apkbox/metdet/SurfmasterPI/ref/SURF3/Вид8.jpg

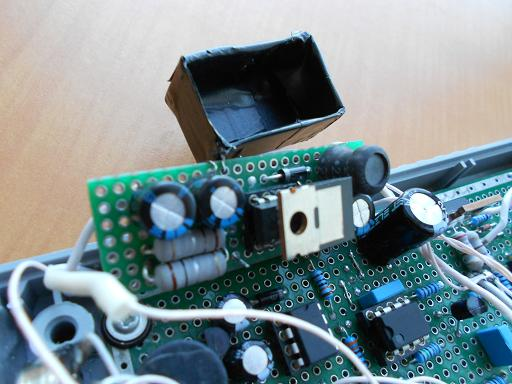
SurfmasterPI/ref/SURF3/Вид8.jpg
