apkbox/metdet/SurfmasterPI/ref/SURF3/Вид7.jpg

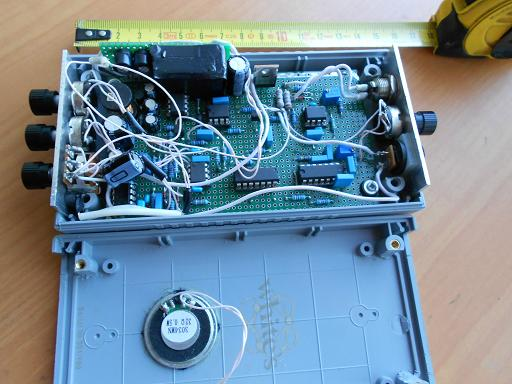
SurfmasterPI/ref/SURF3/Вид7.jpg
