apkbox/metdet/SurfmasterPI/3041_surf_pi_schematic.jpg

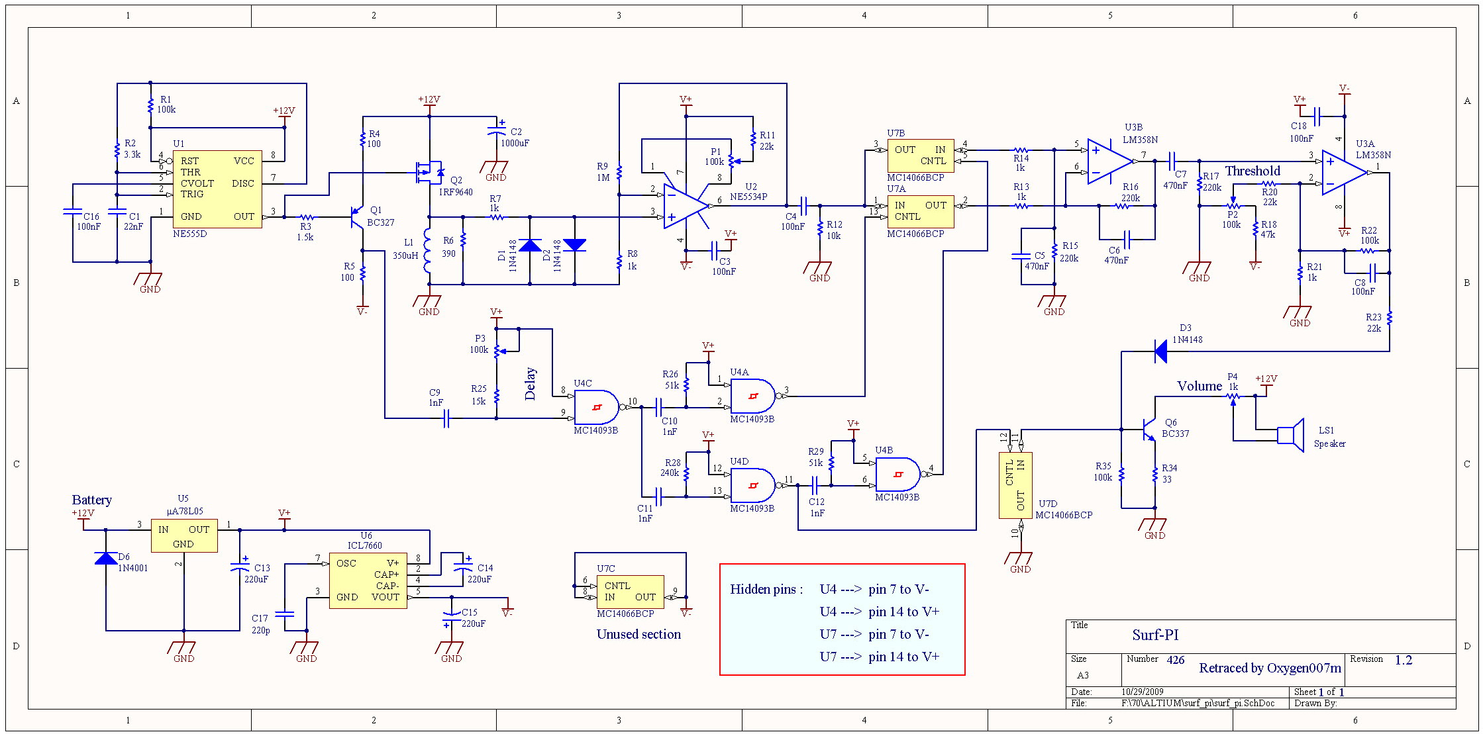
SurfmasterPI/3041_surf_pi_schematic.jpg
