apkbox/metdet/SurfmasterPI/Pro/SurfPiProSch.png

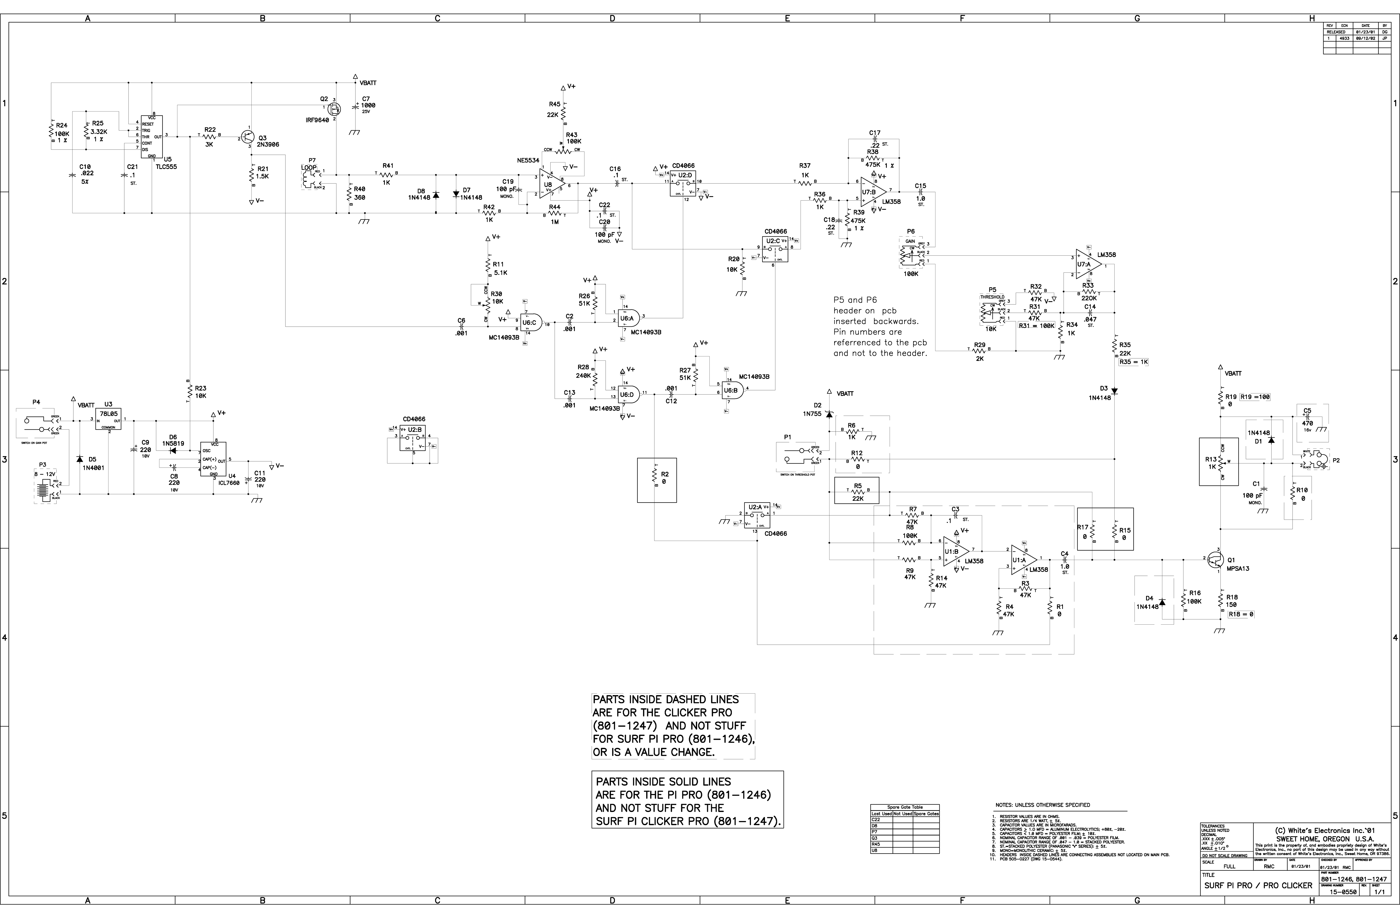
SurfmasterPI/Pro/SurfPiProSch.png
