apkbox/metdet/SurfmasterPI/ref/Cтр,42.jpg

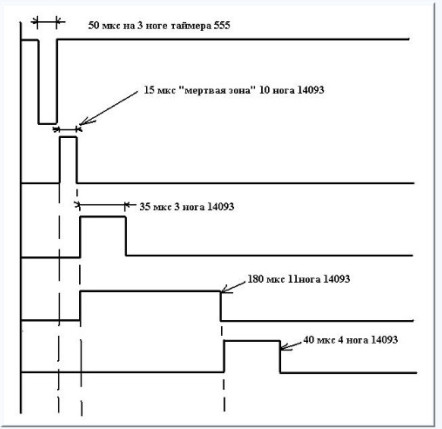
SurfmasterPI/ref/Cтр,42.jpg
