apkbox/metdet/SurfmasterPI/ref/SPProSchematic.png

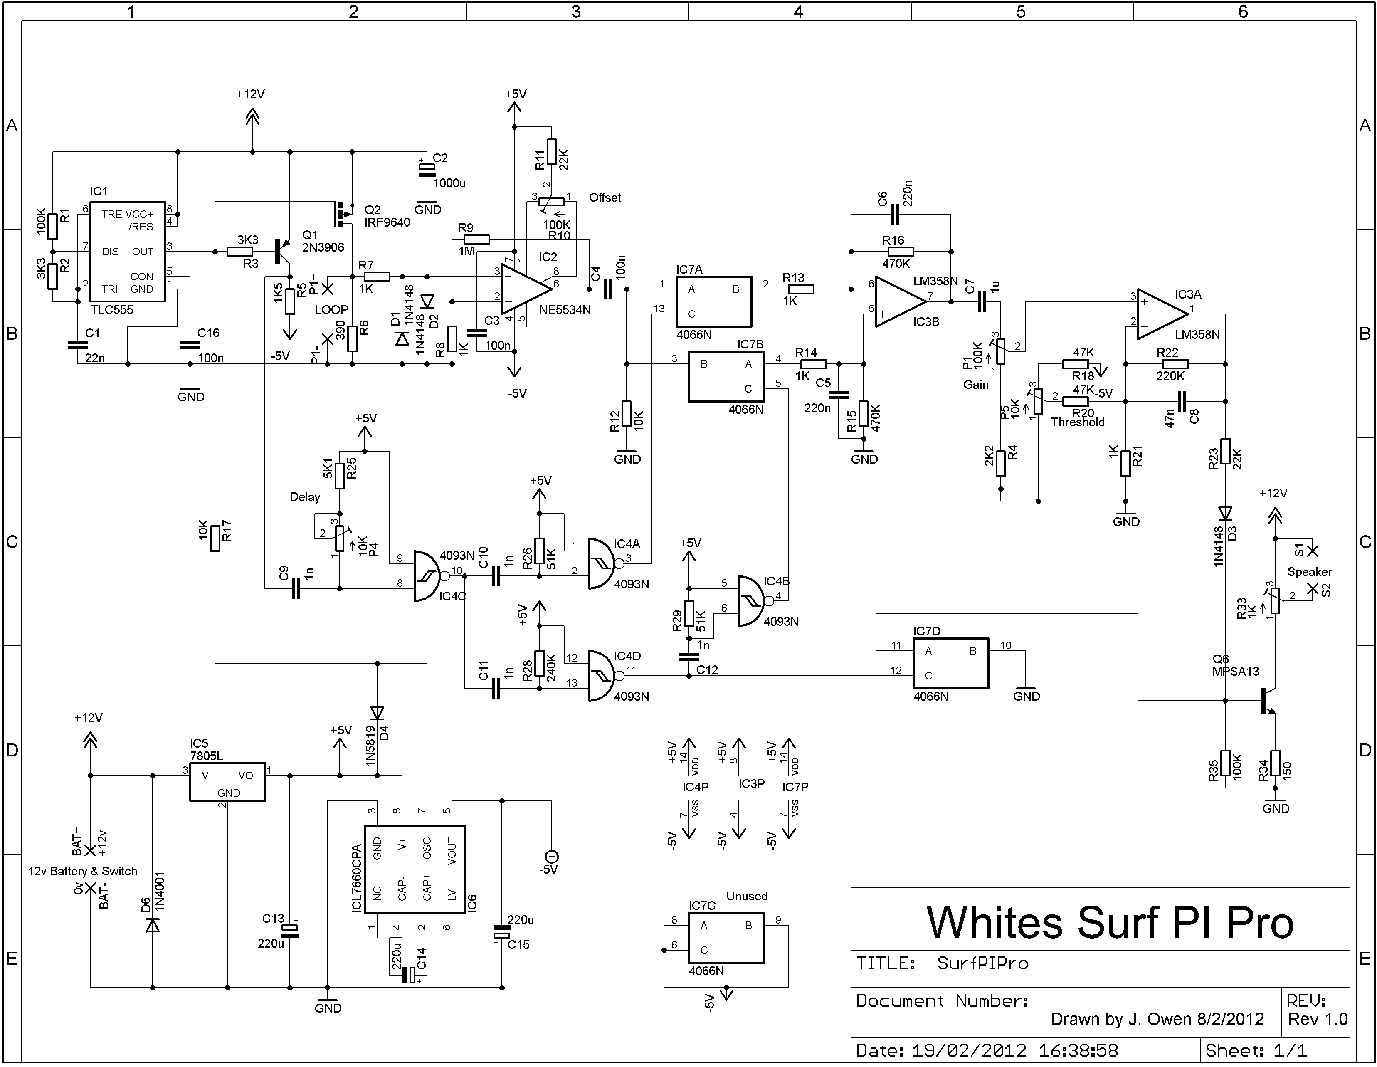
SurfmasterPI/ref/SPProSchematic.png
