apkbox/metdet/SurfmasterPI/ref/SURF1/IMG.jpg

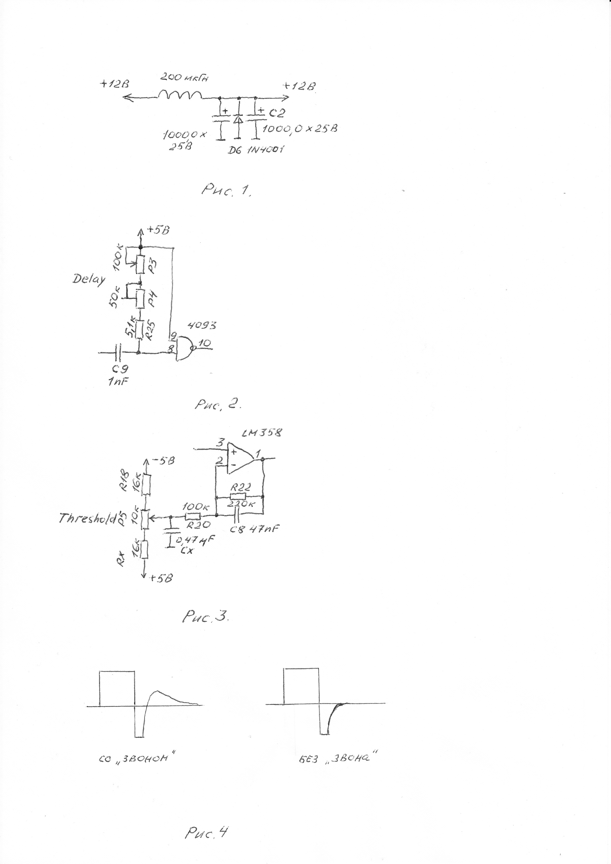
SurfmasterPI/ref/SURF1/IMG.jpg
