apkbox/metdet/SurfmasterPI/ref/SURF2/Вид1.jpg

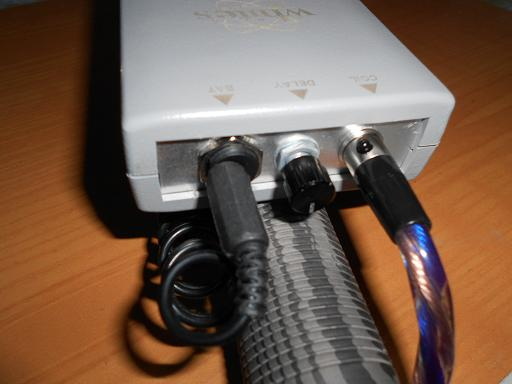
SurfmasterPI/ref/SURF2/Вид1.jpg
