apkbox/metdet/SurfmasterPI/ref/SURF2/Вид2.jpg

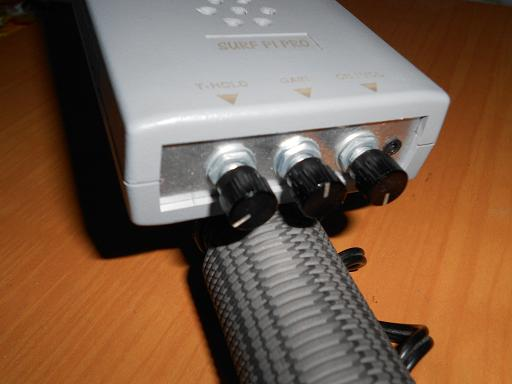
SurfmasterPI/ref/SURF2/Вид2.jpg
