apkbox/metdet/SurfmasterPI/ref/SURF2/Вид3.jpg

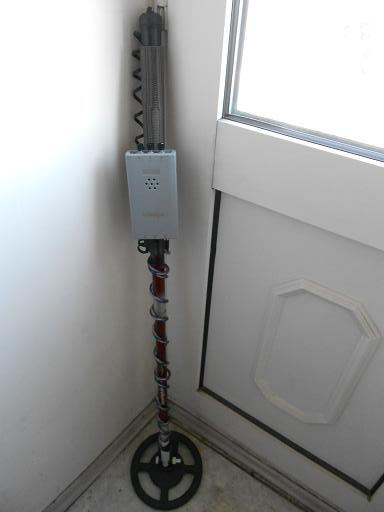
SurfmasterPI/ref/SURF2/Вид3.jpg
