apkbox/metdet/SurfmasterPI/ref/SURF2/Вид4.jpg

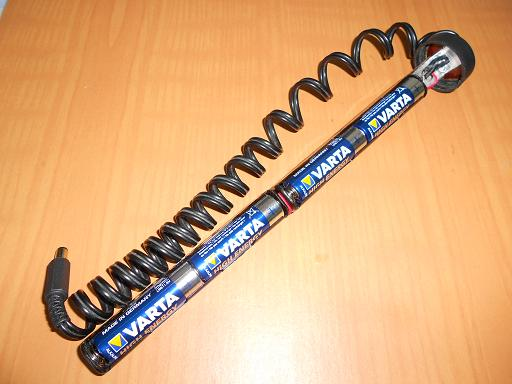
SurfmasterPI/ref/SURF2/Вид4.jpg
