apkbox/metdet/SurfmasterPI/ref/SURF2/Вид5.jpg

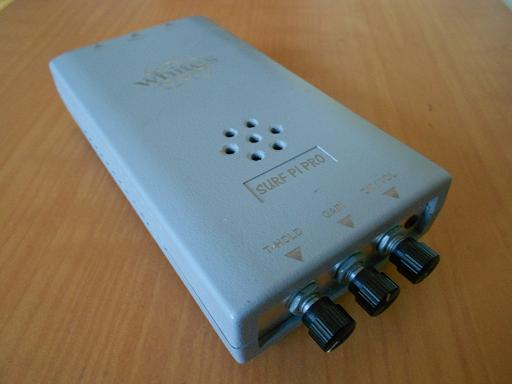
SurfmasterPI/ref/SURF2/Вид5.jpg
