apkbox/metdet/SurfmasterPI/ref/SURF3/Вид6.jpg

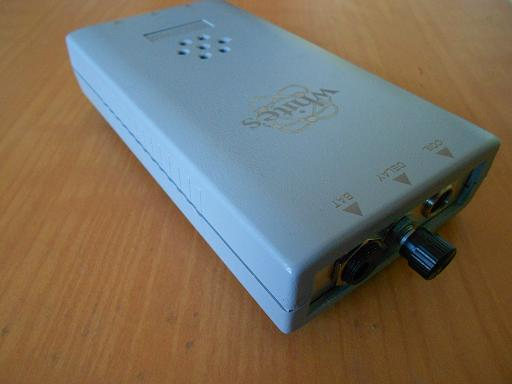
SurfmasterPI/ref/SURF3/Вид6.jpg
