apkbox/metdet/SurfmasterPI/ref/SURF3/Вид9.jpg

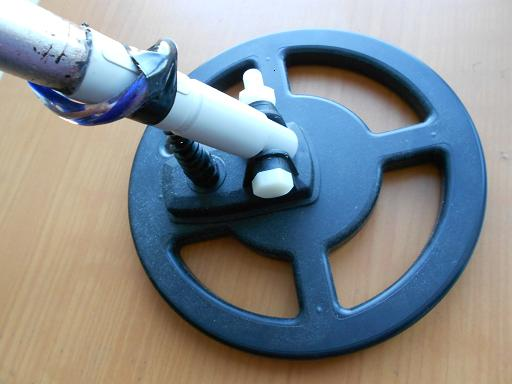
SurfmasterPI/ref/SURF3/Вид9.jpg
