apkbox/metdet/SurfmasterPI/ref/Стр.40.gif

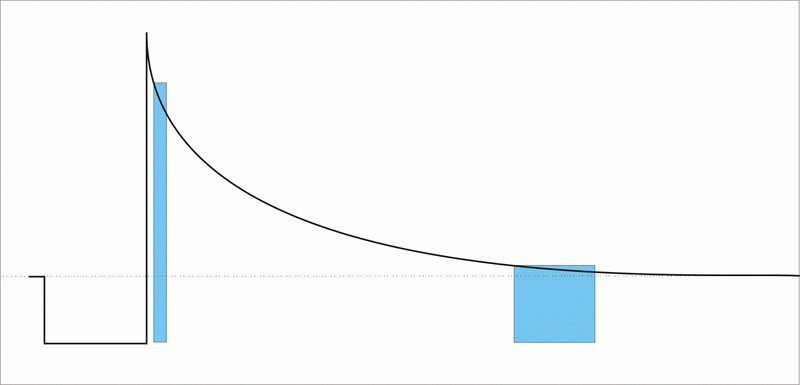
SurfmasterPI/ref/Стр.40.gif
