apkbox/metdet/SurfmasterPI/pcb/SurfmasterPI_pro-B.Cu.pdf

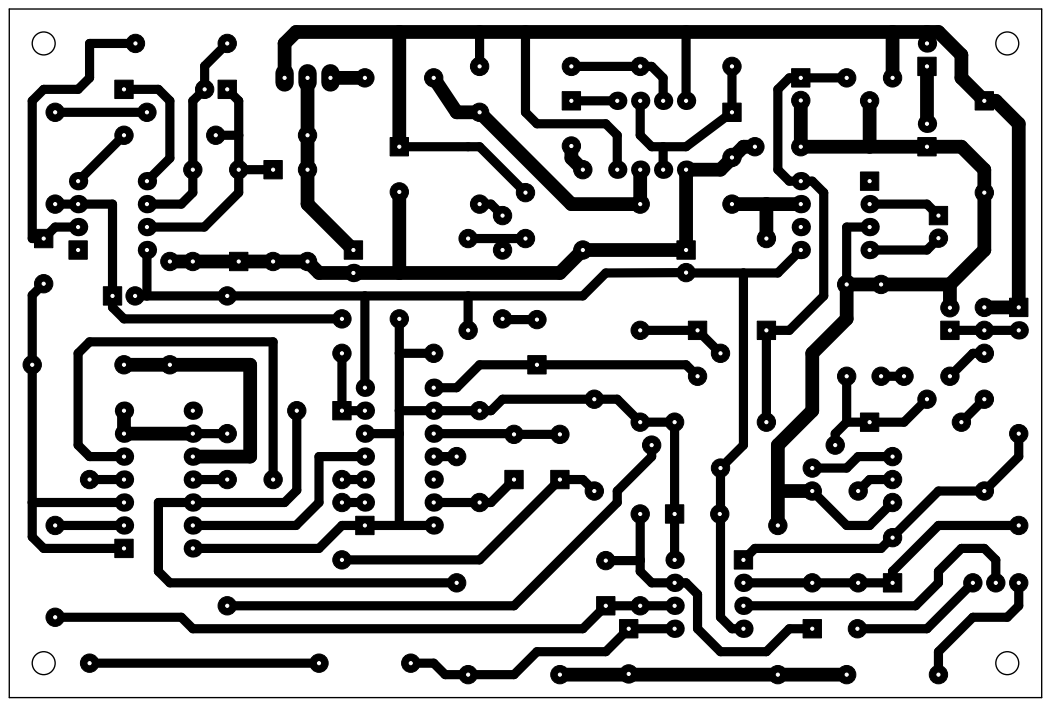
[picture p16: page 1]
