apkbox/metdet/(list of files, drawings)

Other design files:
SurfmasterPI/100_70vv__________________20_03_2012.lay
