apkbox/metdet/SurfmasterPI/pcb/SurfmasterPI_pro.kicad_pcb

## KiCad design SurfmasterPI/pcb/SurfmasterPI_pro.kicad_pcb (2016-09-07)

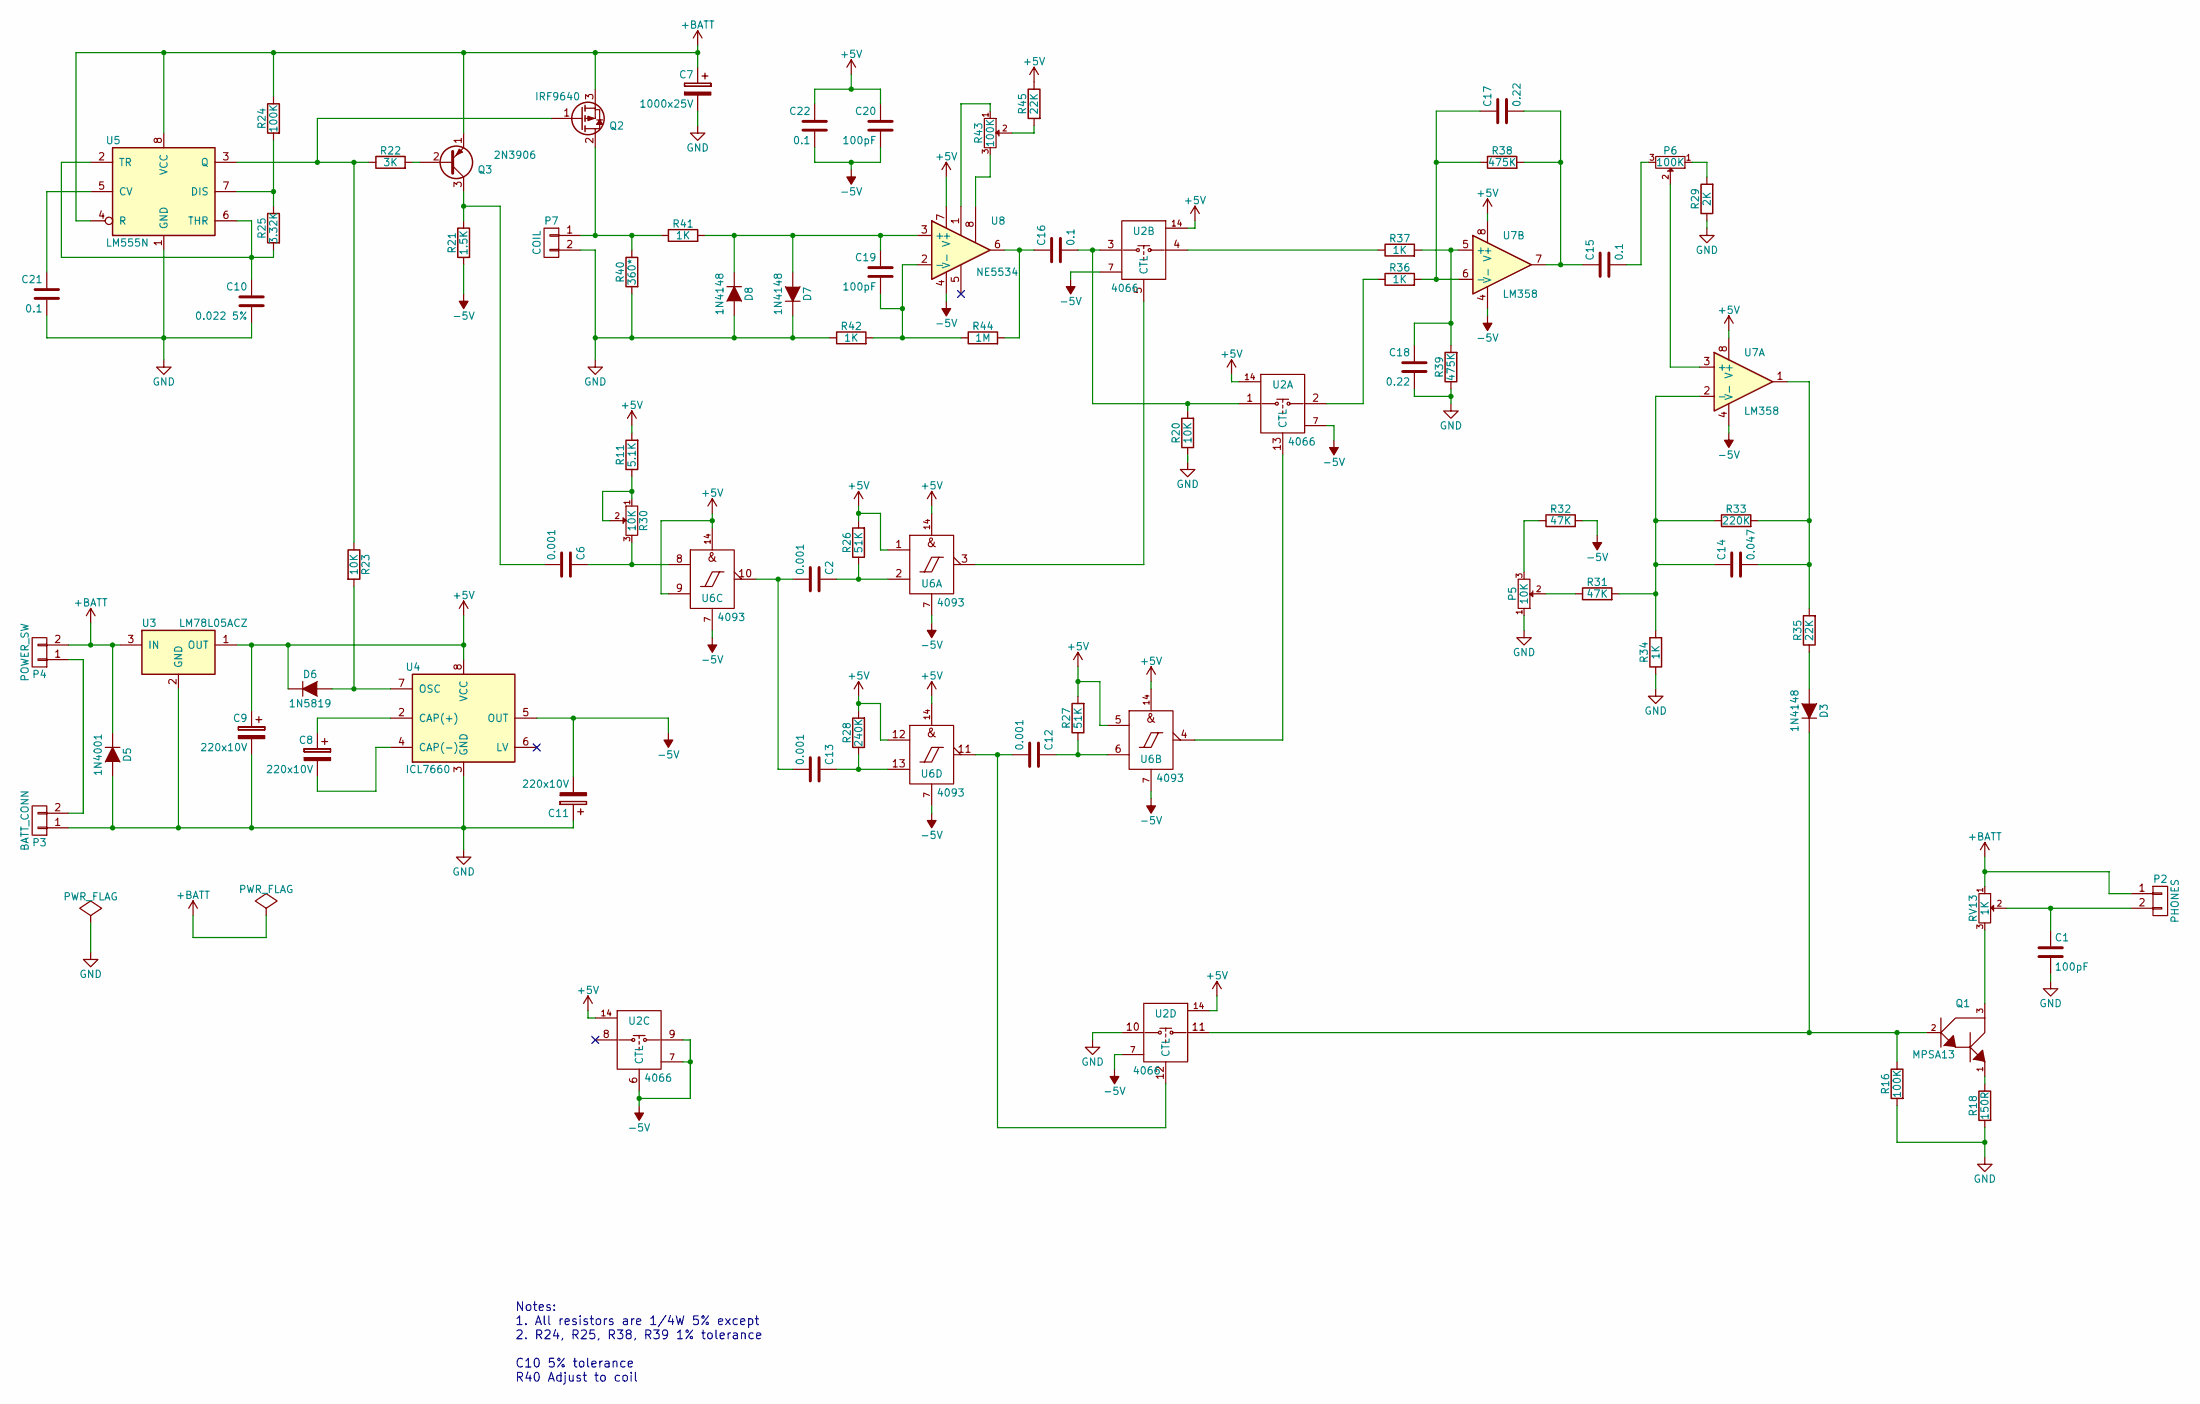
[picture p17: schematic SurfmasterPI_pro.sch]

Parts:
C1, C19, C20: 100pF; C_Disc_D3_P2.5
C2, C6, C12, C13: 0.001; C_Disc_D6_P5
C7: 1000x25V; C_Radial_D13_L21_P5
C8, C9, C11: 220x10V; C_Radial_D7.5_L11.2_P2.5
C10: 0.022 5%; C_Disc_D6_P5
C14: 0.047; C_Disc_D6_P5
C15, C16, C21, C22: 0.1; C_Disc_D6_P5
C17, C18: 0.22; C_Disc_D6_P5
D3, D7, D8: 1N4148; Diode_DO-41_SOD81_Horizontal_RM10
D5: 1N4001; Diode_DO-35_SOD27_Horizontal_RM10
D6: 1N5819; Diode_DO-35_SOD27_Horizontal_RM10
P2: PHONES; Pin_Header_Straight_1x02
P3: BATT_CONN; Pin_Header_Straight_1x02
P4: POWER_SW; Pin_Header_Straight_1x02
P5: 10K; Potentiometer_WirePads_Small
P6: 100K; Potentiometer_WirePads_Small
P7: COIL; Pin_Header_Straight_1x02
Q1: MPSA13; TO-92_Molded_Narrow
Q2: IRF9640; TO-220_Neutral123_Vertical_LargePads
Q3: 2N3906; TO-92_Molded_Narrow
R11: 5.1K; Resistor_Horizontal_RM10mm
R16, R24: 100K; Resistor_Horizontal_RM10mm
R18: 150R; Resistor_Horizontal_RM10mm
R20, R23: 10K; Resistor_Horizontal_RM10mm
R21: 1.5K; Resistor_Horizontal_RM10mm
R22: 3K; Resistor_Horizontal_RM10mm
R25: 3.32K; Resistor_Horizontal_RM10mm
R26, R27: 51K; Resistor_Horizontal_RM10mm
R28: 240K; Resistor_Horizontal_RM10mm
R29: 2K; Resistor_Horizontal_RM10mm
R30: 10K; Potentiometer_Trimmer-Suntan-TSR-3386P
R31, R32: 47K; Resistor_Horizontal_RM10mm
R33: 220K; Resistor_Horizontal_RM10mm
R34, R36, R37, R41, R42: 1K; Resistor_Horizontal_RM10mm
R35, R45: 22K; Resistor_Horizontal_RM10mm
R38, R39: 475K; Resistor_Horizontal_RM10mm
R40: 360*; Resistor_Horizontal_RM10mm
R43: 100K; Potentiometer_Trimmer-Suntan-TSR-3386P
R44: 1M; Resistor_Horizontal_RM10mm
RV13: 1K; Potentiometer_WirePads_Small
U2: 4066; DIP-14_W7.62mm_LongPads
U3: LM78L05ACZ; TO-92_Molded_Narrow
U4: ICL7660; DIP-8_W7.62mm_LongPads
U5: LM555N; DIP-8_W7.62mm_LongPads
U6: 4093; DIP-14_W7.62mm_LongPads
U7: LM358; DIP-8_W7.62mm_LongPads
U8: NE5534; DIP-8_W7.62mm_LongPads

Connections:
+5V: C9.1, C20.1, C22.1, D6.1 (K), R11.2, R26.2, R27.2, R28.2, R45.1, U2.14, U3.1 (OUT), U4.8 (VCC), U6.1, U6.5, U6.9, U6.12, U6.14, U7.8 (V+), U8.7 (V+)
+BATT: C7.1, D5.1 (K), P2.1, P4.2, Q2.3 (S), Q3.1 (E), R24.1, RV13.1, U3.3 (IN), U5.4 (R), U5.8 (VCC)
-5V: C11.2, C20.2, C22.2, R21.2, R32.2, U2.6 (CTL), U2.7, U2.9, U4.5 (OUT), U6.7, U7.4 (V-), U8.4 (V-)
GND: C1.2, C7.2, C9.2, C10.2, C11.1, C18.2, C21.2, D5.2 (A), D7.1 (K), D8.2 (A), P3.1, P5.1, P7.2, R16.2, R18.2, R20.1, R29.1, R34.1, R39.1, R40.2, R42.1, U2.10, U3.2 (GND), U4.3 (GND), U5.1 (GND)
unnamed: C1.1, P2.2, RV13.2
unnamed: C2.1, R26.1, U6.2
unnamed: C6.1, R30.3, U6.8
unnamed: C6.2, Q3.3 (C), R21.1
unnamed: C8.1, U4.2 (CAP(+))
unnamed: C8.2, U4.4 (CAP(-))
unnamed: C10.1, R25.2, U5.2 (TR), U5.6 (THR)
unnamed: C12.1, R27.1, U6.6
unnamed: C12.2, U2.12 (CTL), U6.11
unnamed: C13.1, R28.1, U6.13
unnamed: C2.2, C13.2, U6.10
unnamed: C14.1, R31.2, R33.1, R34.2, U7.2 (-)
unnamed: C14.2, R33.2, R35.2, U7.1
unnamed: C15.1, C17.2, R38.2, U7.7
unnamed: C15.2, P6.3
unnamed: C16.1, R44.2, U8.6
unnamed: C16.2, R20.2, U2.1, U2.3
unnamed: C17.1, R36.2, R38.1, U7.6 (-)
unnamed: C18.1, R37.2, R39.2, U7.5 (+)
unnamed: C19.1, D7.2 (A), D8.1 (K), R41.2, U8.3 (+)
unnamed: C19.2, R42.2, R44.1, U8.2 (-)
unnamed: C21.1, U5.5 (CV)
unnamed: D3.1 (K), Q1.2, R16.1, U2.11
unnamed: D3.2 (A), R35.1
unnamed: D6.2 (A), R23.2, U4.7 (OSC)
unnamed: P3.2, P4.1
unnamed: P5.2, R31.1
unnamed: P5.3, R32.1
unnamed: P6.1, R29.2
unnamed: P6.2, U7.3 (+)
unnamed: P7.1, Q2.2 (D), R40.1, R41.1
unnamed: Q1.1, R18.1
unnamed: Q1.3, RV13.3
unnamed: Q2.1 (G), R22.1, R23.1, U5.3 (Q)
unnamed: Q3.2 (B), R22.2
unnamed: R11.1, R30.1, R30.2
unnamed: R24.2, R25.1, U5.7 (DIS)
unnamed: R36.1, U2.2
unnamed: R37.1, U2.4
unnamed: R43.1, U8.1
unnamed: R43.2, R45.2
unnamed: R43.3, U8.8
unnamed: U2.5 (CTL), U6.3
unnamed: U2.13 (CTL), U6.4

Notes on the sheet:
Notes: 1. All resistors are 1/4W 5% except 2. R24, R25, R38, R39 1% tolerance C10 5% tolerance R40 Adjust to coil

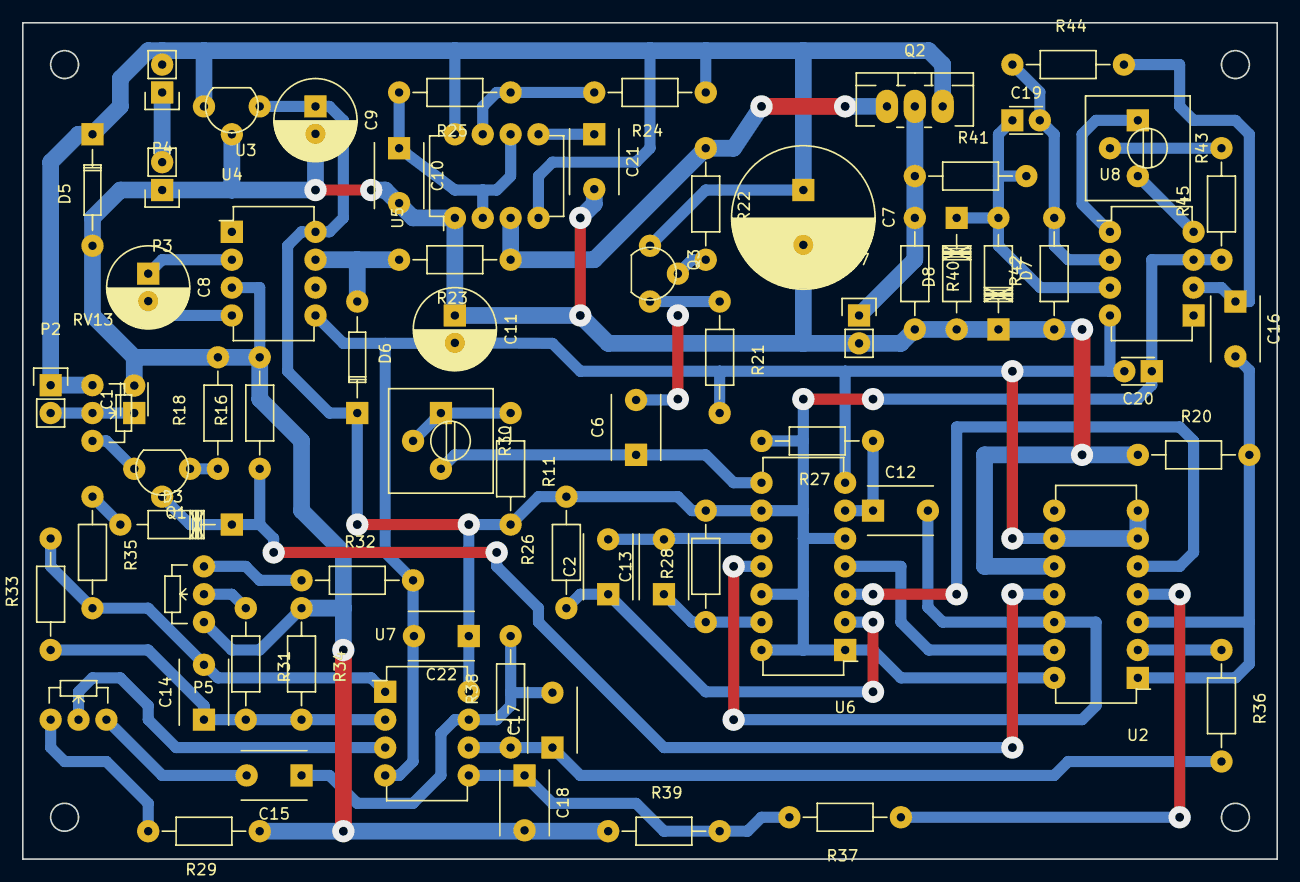
[picture p18: board SurfmasterPI_pro.kicad_pcb from above]

Board: 2 copper layers, 114.3 x 76.2 mm, 70 parts (0 on the bottom side), 48 nets.
