apkbox/metdet/(commit log)

2016-08-28 Initial commit.
    [100_70vv__________________20_03_2012.lay, SurfmasterPI.kicad_pcb, SurfmasterPI_full.sch, SurfmasterPI_pro.kicad_pcb, SurfmasterPI_pro.sch, first_try.kicad_pcb]
2016-08-28 Some changes.
    [SurfmasterPI_pro.csv, SurfmasterPI_pro.kicad_pcb, SurfmasterPI_pro.sch, SurfmasterPI_pro_unfilled.csv]
2016-08-28 Added patent. Changed TO-92 footprint to compact one.
    [SurfmasterPI_pro.kicad_pcb, SurfmasterPI_pro.sch]
2016-08-29 Finished first version of PCB layout for pro.
    [SurfmasterPI_pro.kicad_pcb, SurfmasterPI_pro.sch]
2016-08-29 Updated PCB holes and pads for low res fabrication.
    [SurfmasterPI_pro.kicad_pcb]
2016-09-07 Fixed missing trace from +5 to 4093 pin 12.
    [SurfmasterPI_pro.kicad_pcb]
